BobAdamsEE/bitaxe/3d/SIC431AED-T1-GE3.step

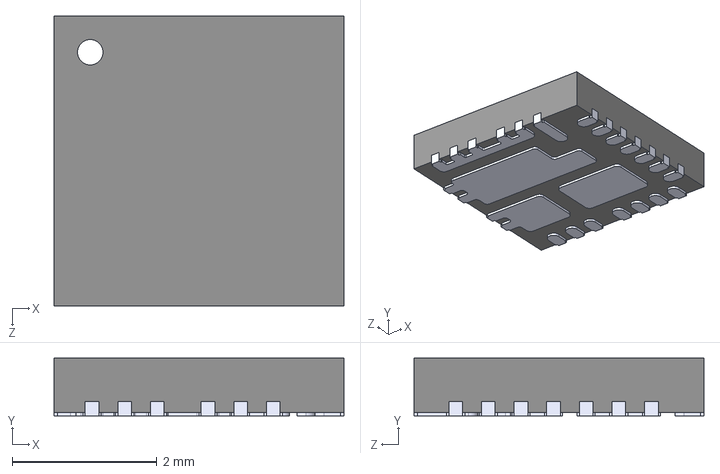
[picture p1: CAD file, 2024-03-04]
3d/SIC431AED-T1-GE3.step
4.00 x 0.8 x 4.00 mm
