BobAdamsEE/bitaxe/3d/SPB1007.stp

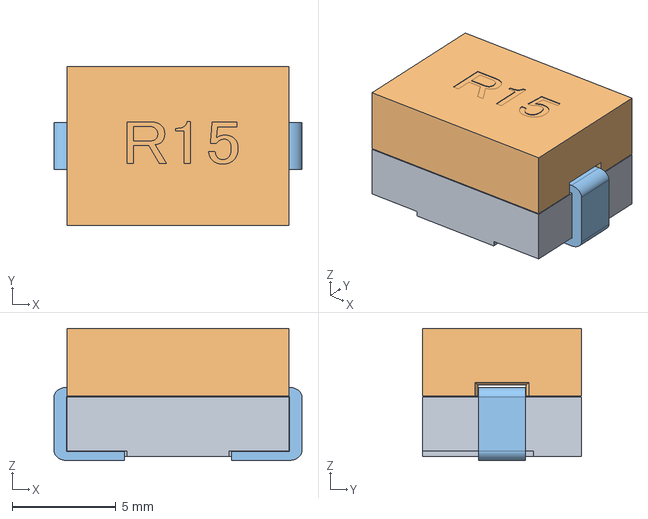
[picture p2: CAD file, 2024-03-04]
3d/SPB1007.stp
12.0 x 7.65 x 6.36 mm
