BobAdamsEE/bitaxe/3d/CAP_WCAP-ASLI_06p3X07p7_WRE.step

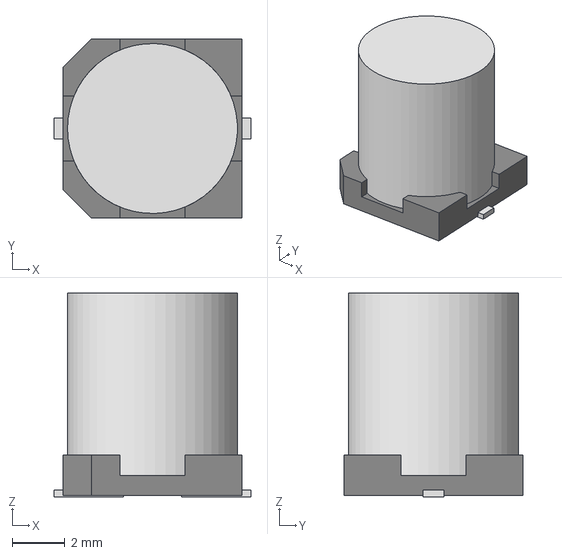
[picture p3: CAD file, 2024-03-04]
3d/CAP_WCAP-ASLI_06p3X07p7_WRE.step
7.49 x 6.81 x 7.75 mm
