BobAdamsEE/bitaxe/3d/TSOT26_DIO.step

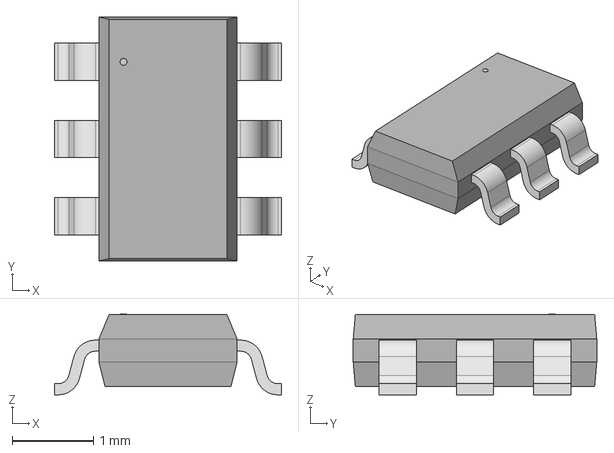
[picture p4: CAD file, 2024-03-04]
3d/TSOT26_DIO.step
2.79 x 3.00 x 0.993 mm
