BobAdamsEE/bitaxe/3d/VLS5045EX-100M.step

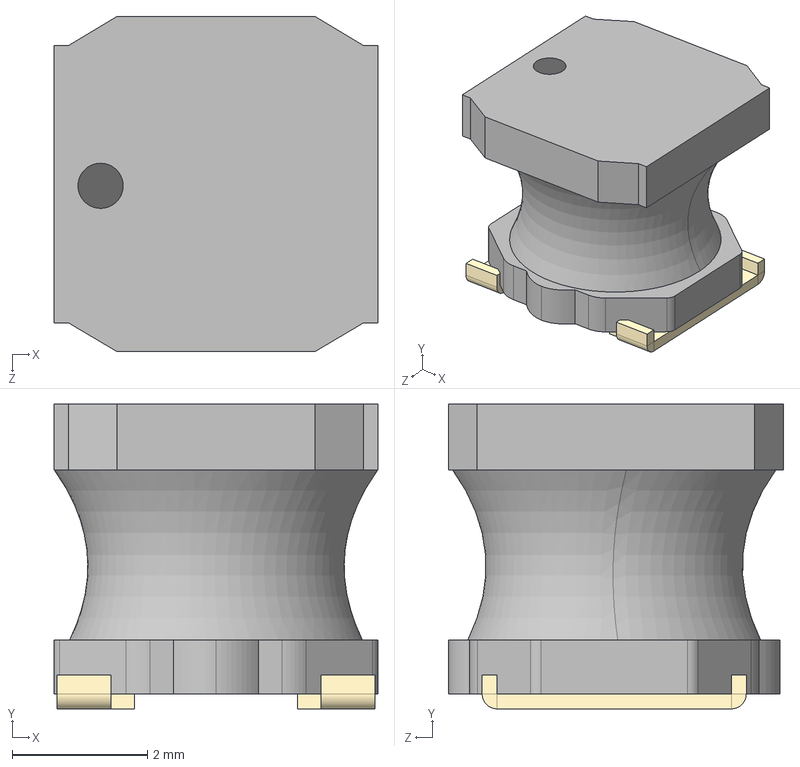
[picture p5: CAD file, 2024-03-04]
3d/VLS5045EX-100M.step
4.78 x 4.50 x 4.95 mm
