BobAdamsEE/bitaxe/3d/SN74AVC4T774PWR.step

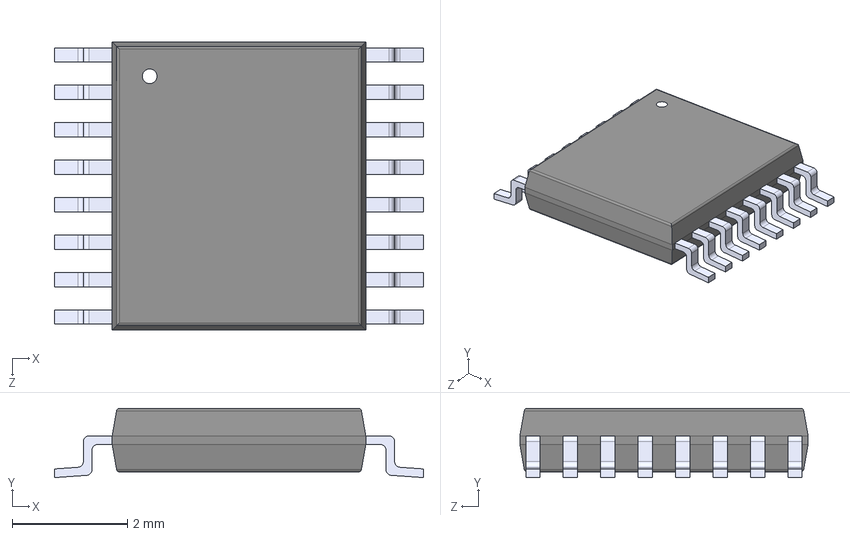
[picture p6: CAD file, 2024-02-27]
3d/SN74AVC4T774PWR.step
6.40 x 1.20 x 5.00 mm
