BobAdamsEE/bitaxe/3d/CUI_DEVICES_PJ-036AH-SMT-TR.step

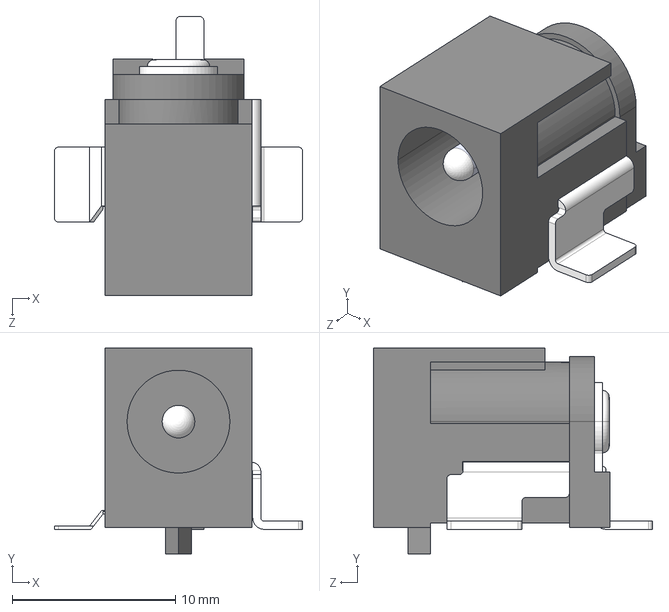
[picture p7: CAD file, 2024-02-14]
3d/CUI_DEVICES_PJ-036AH-SMT-TR.step
15.2 x 12.6 x 17.1 mm
