BobAdamsEE/bitaxe/Bitaxe_205pd_draft_sch.pdf

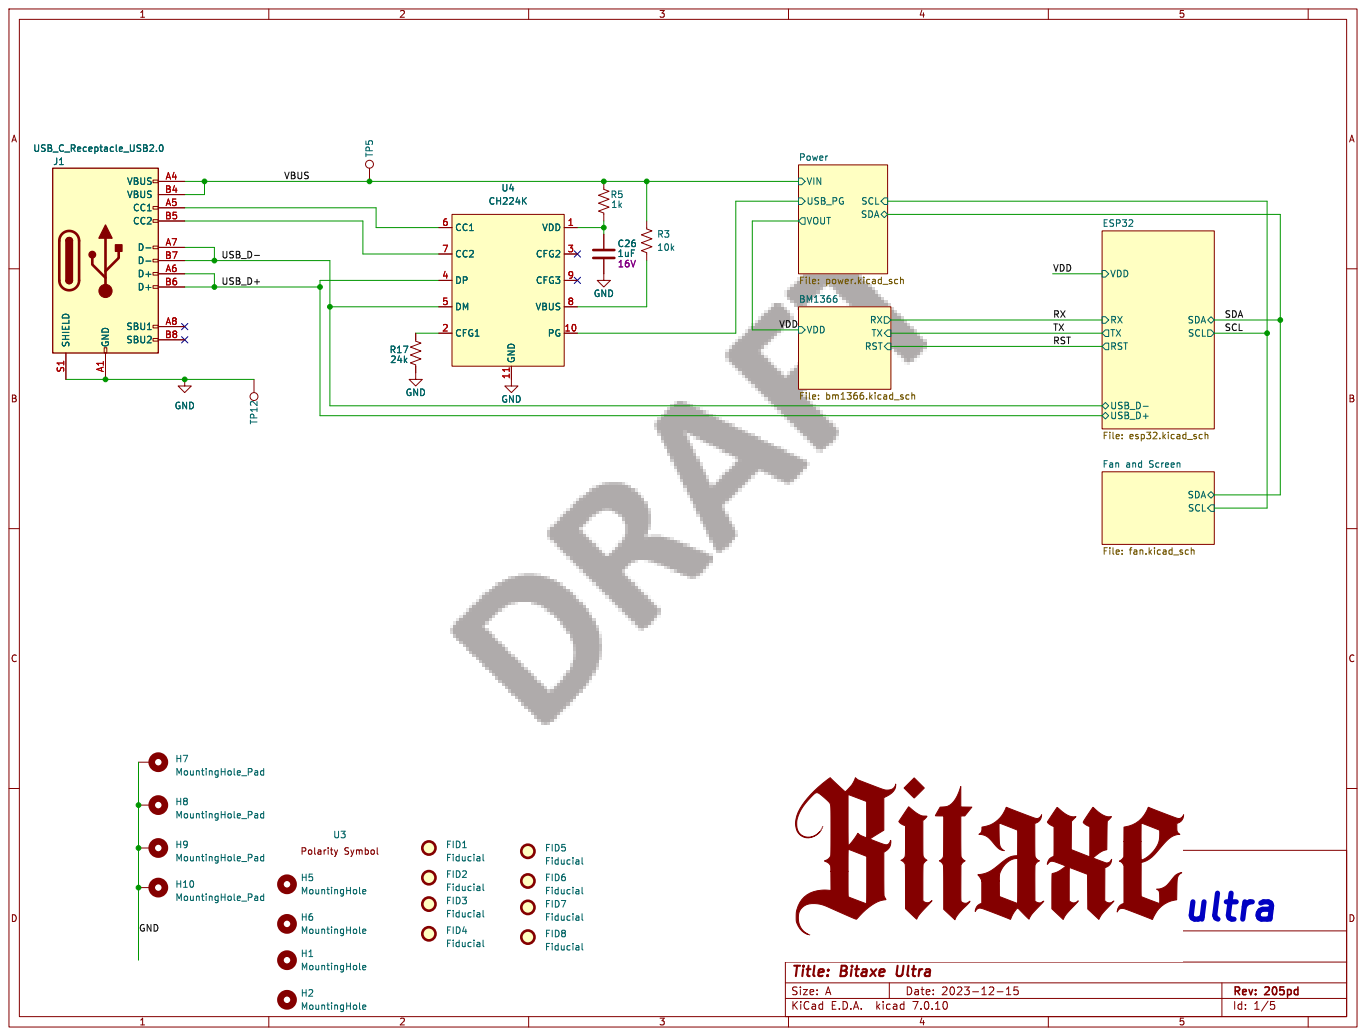
[picture p8: page 1]

Power File: power.kicad_sch TXRX RST VDD

SCL Fan and Screen File: fan.kicad_sch H6 MountingHole

File: bitaxeUltra.kicad_sch Sheet: /
Id: 1/5 Title: Bitaxe Ultra

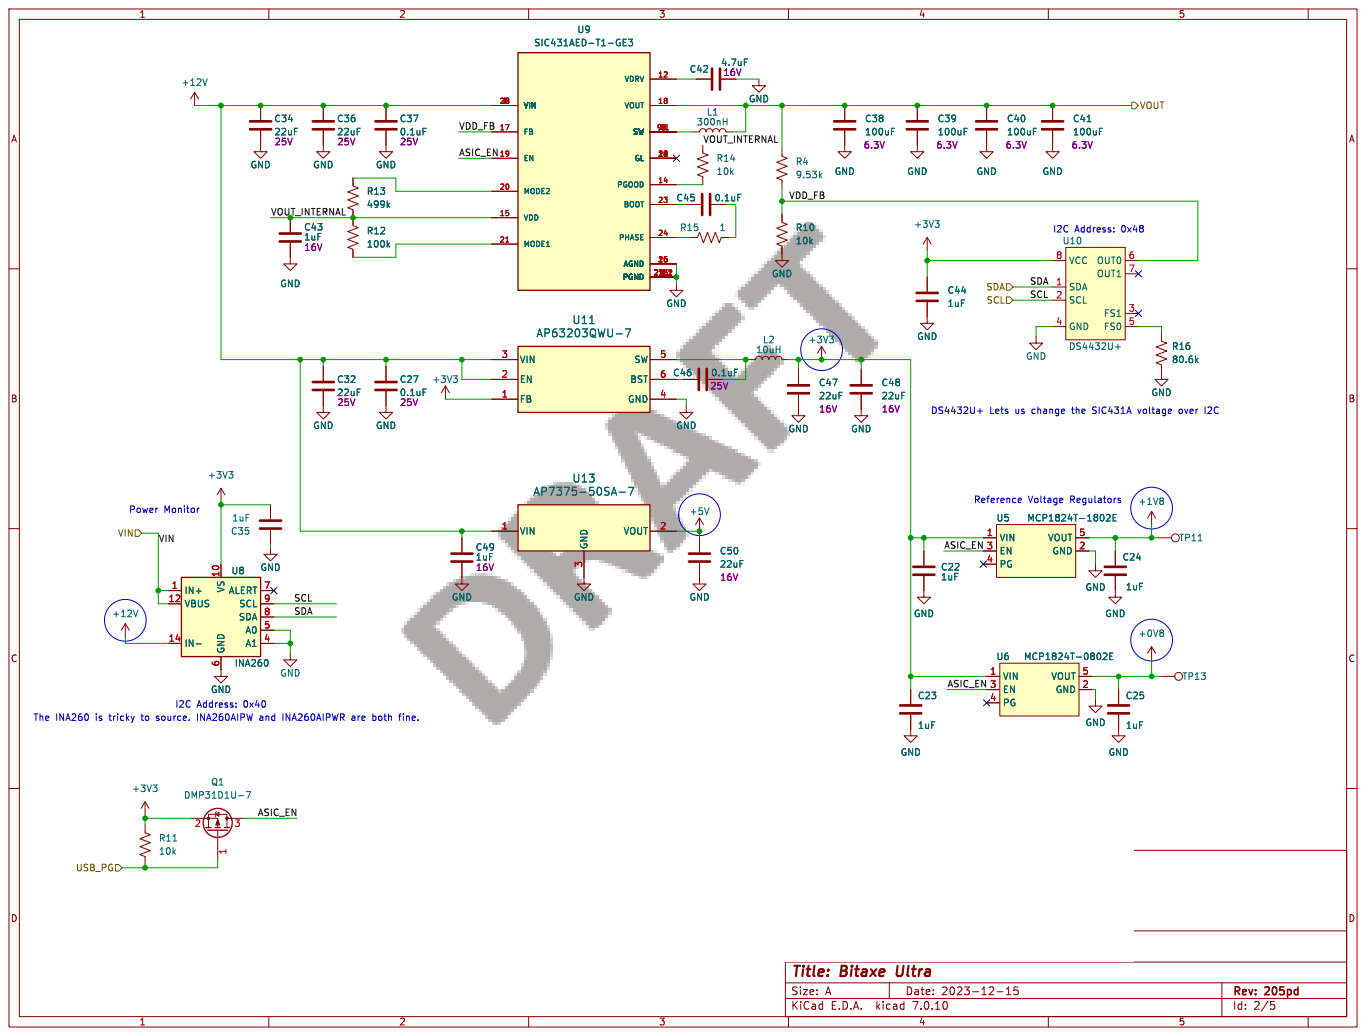
[picture p9: page 2]

Reference Voltage Regulators GND

I2C Address: 0x40 The INA260 is tricky to source. INA260AIPW and INA260AIPWR are both fine. Power Monitor

6 ALERT 7 SDA 8 SCL 9GND GND GND

File: power.kicad_sch Sheet: /Power/
Id: 2/5 Title: Bitaxe Ultra

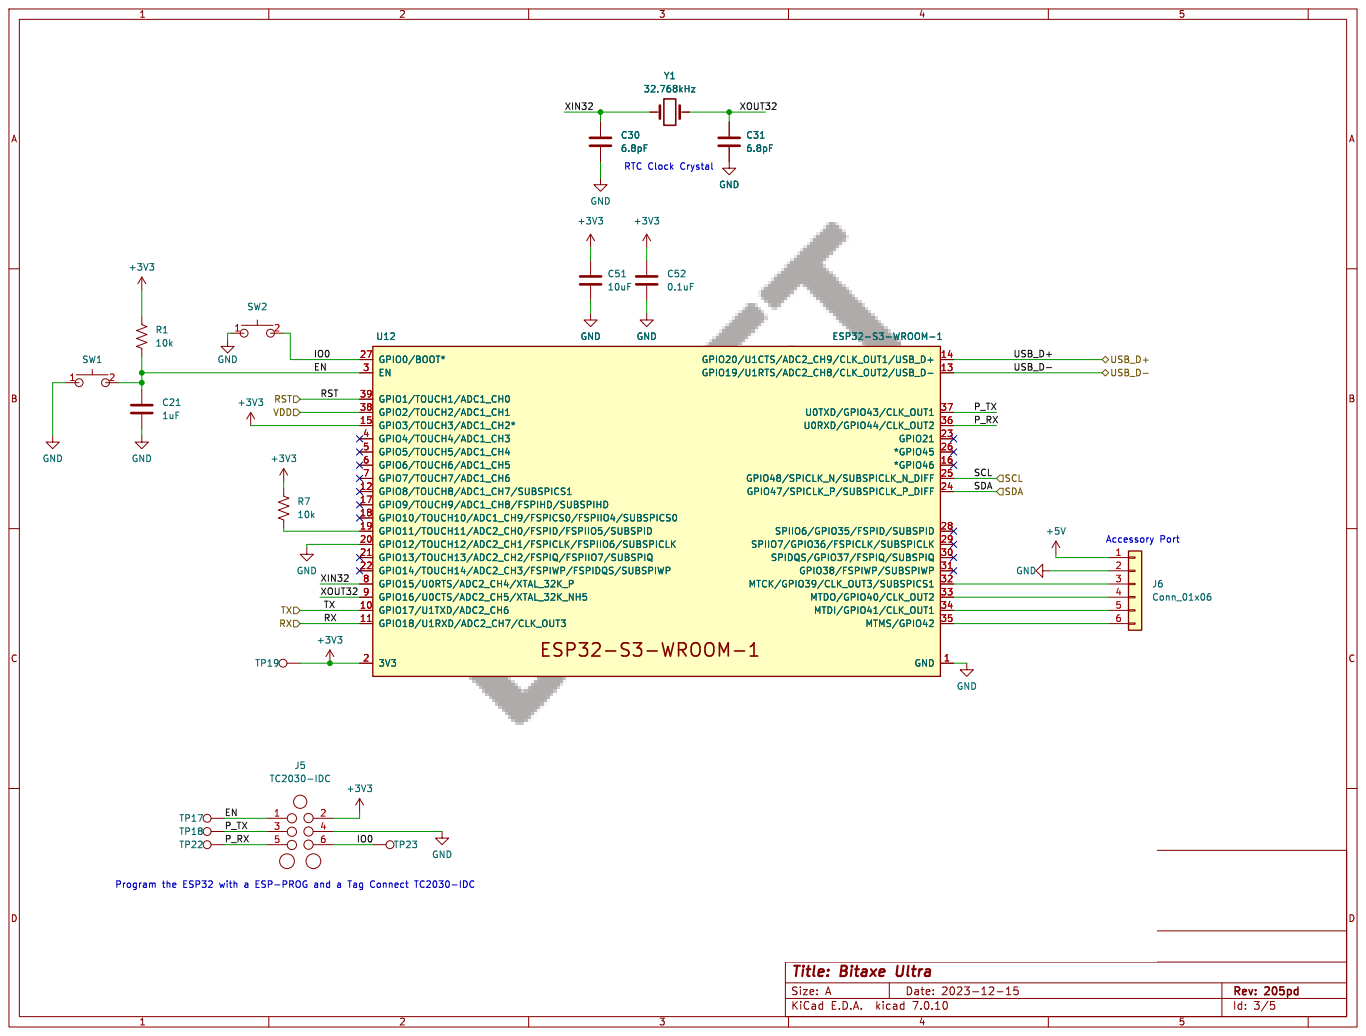
[picture p10: page 3]

Accessory Port Program the ESP32 with a ESP-PROG and a Tag Connect TC2030-IDC

Id: 3/5 Title: Bitaxe Ultra

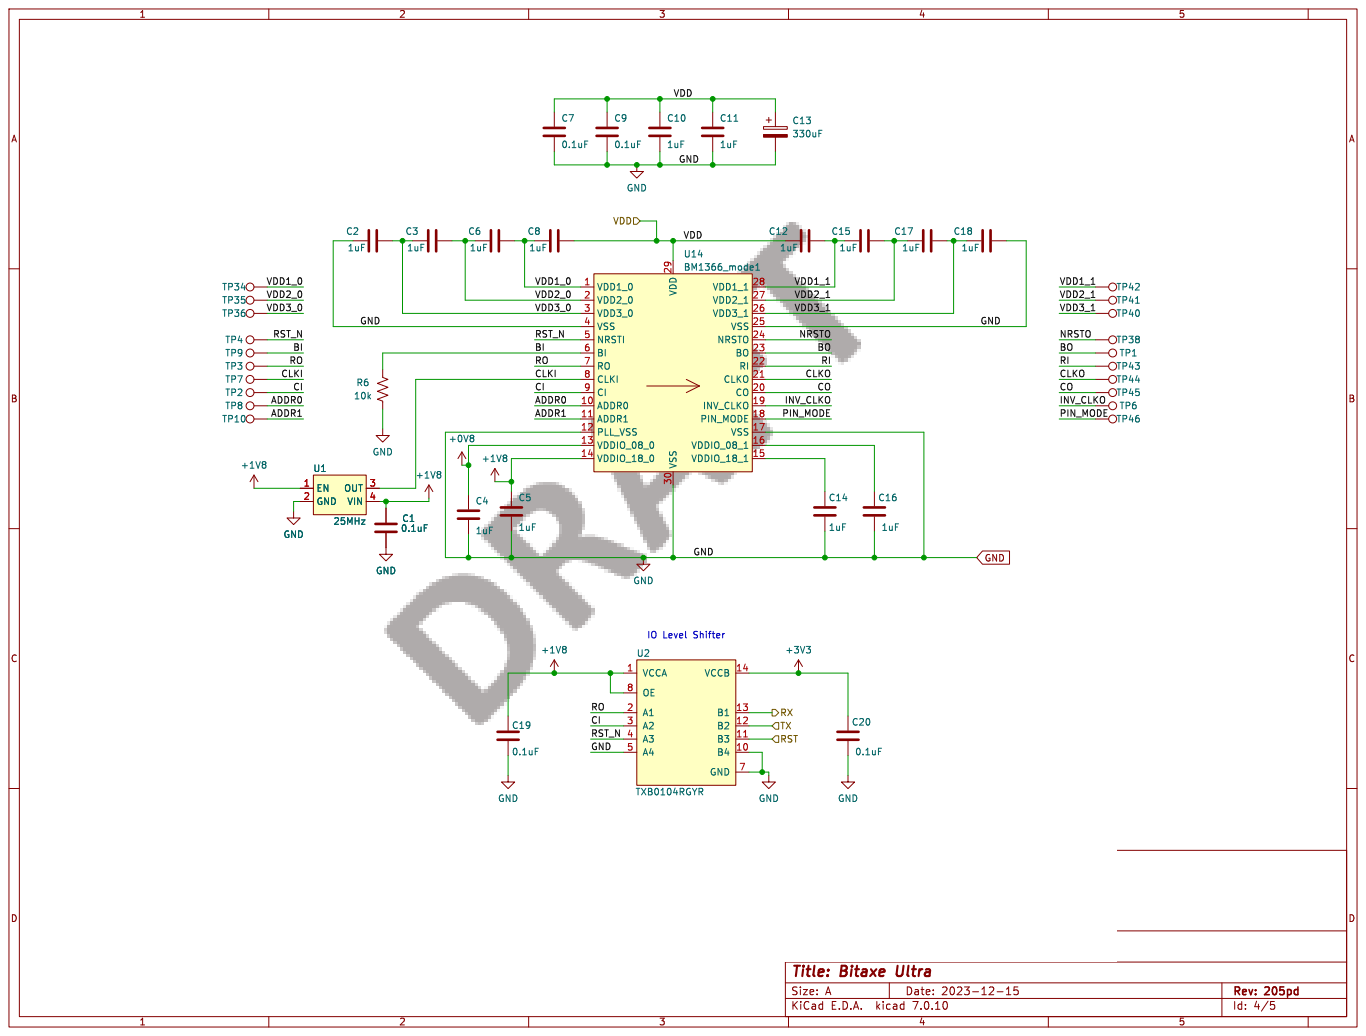
[picture p11: page 4]

IO Level Shifter GND

Id: 4/5 Title: Bitaxe Ultra

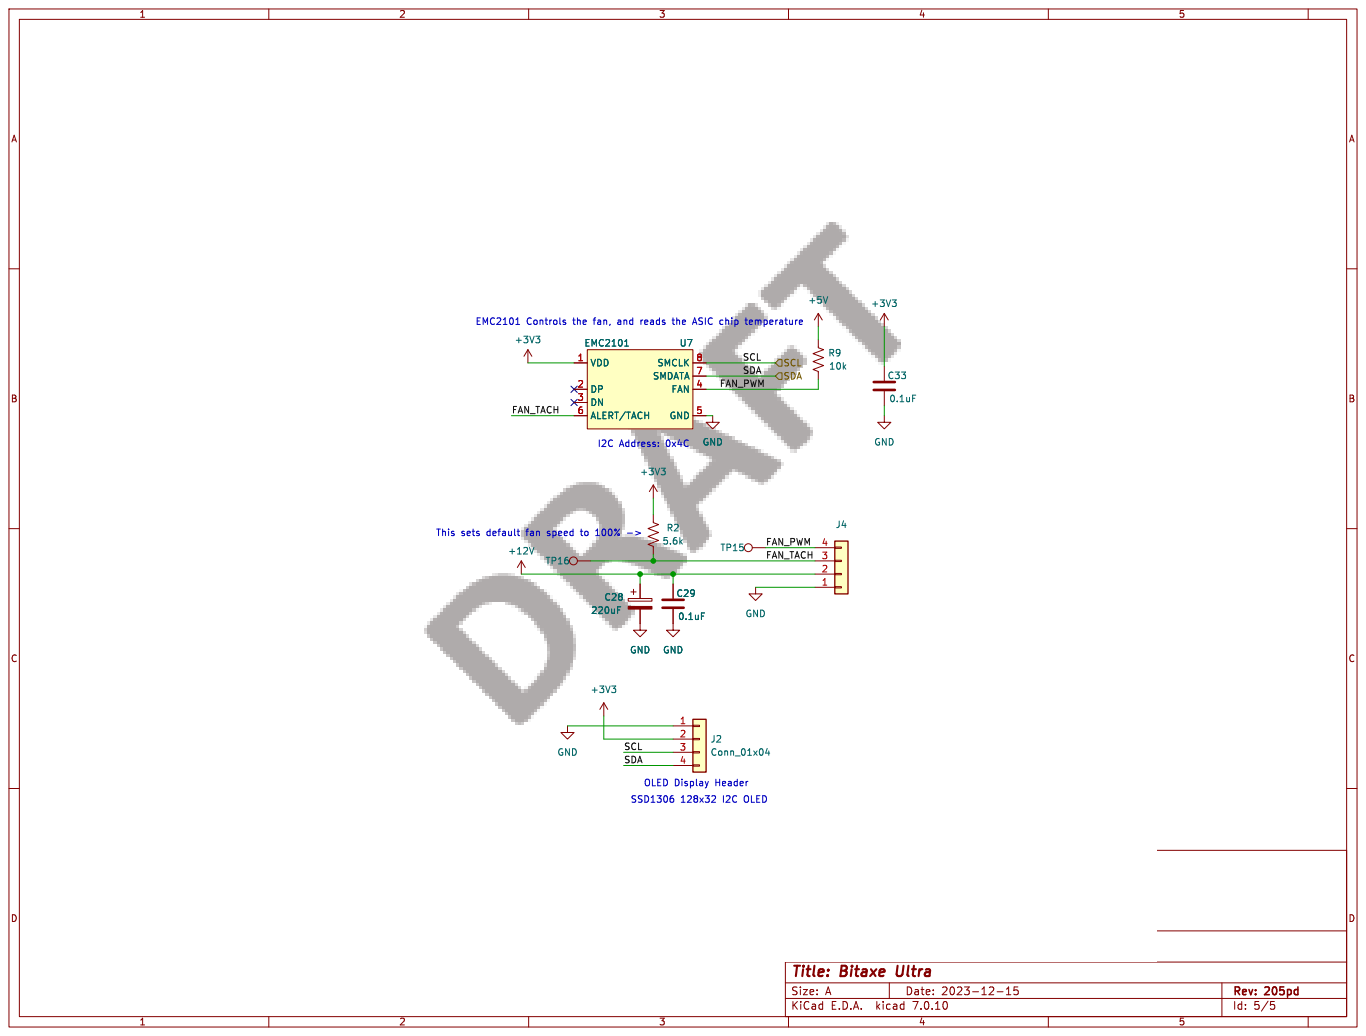
[picture p12: page 5]

SSD1306 128x32 I2C OLED OLED Display Header

Id: 5/5 Title: Bitaxe Ultra
