BobAdamsEE/bitaxe/bitaxeUltra.kicad_pcb

## KiCad design bitaxeUltra.kicad_pcb (2024-03-21)

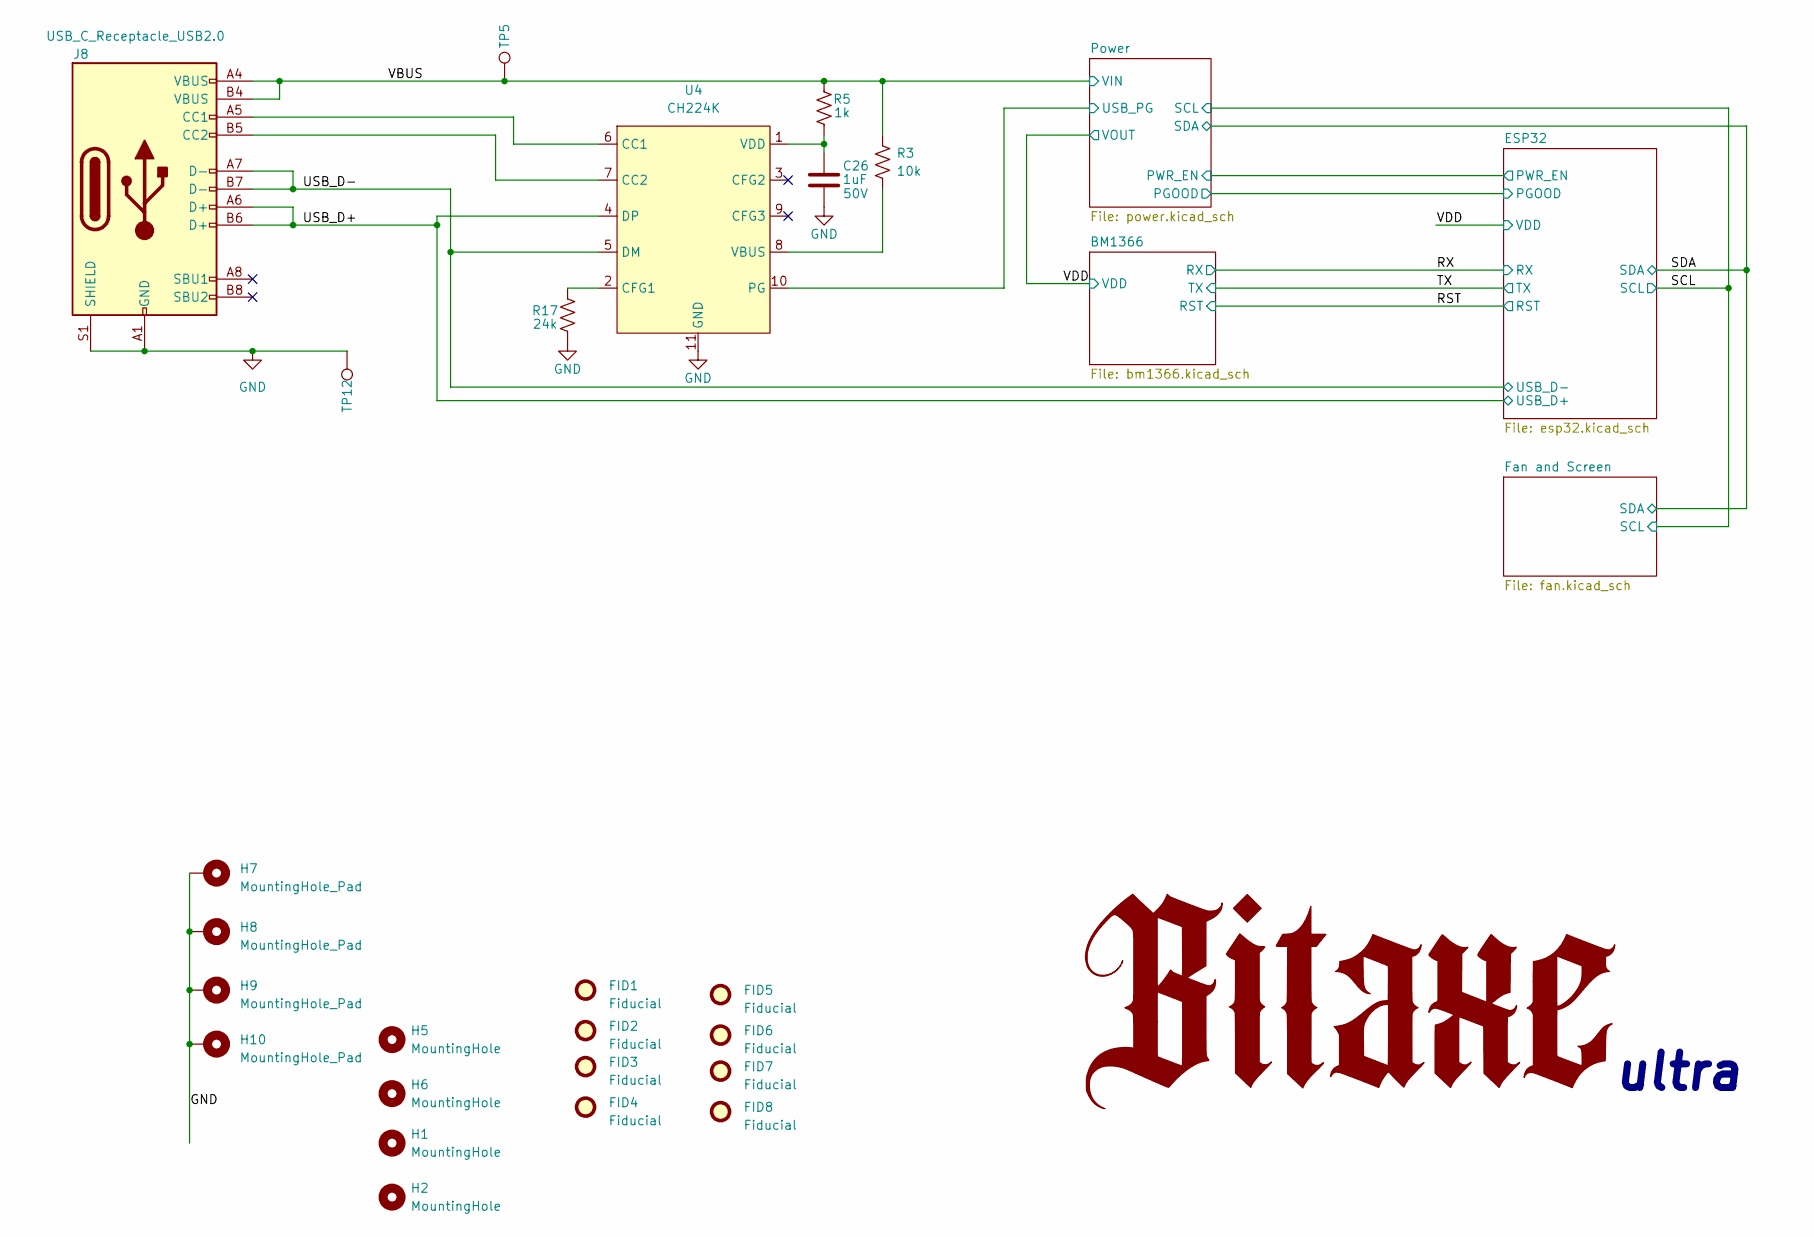
[picture p13: schematic bitaxeUltra.kicad_sch, Bitaxe Ultra]

Parts:
C26: 1uF; C_0603_1608Metric; Voltage 50V; PARTNO CC0603KRX7R9BB105
FID1, FID2, FID3, FID4, FID5, FID6, FID7, FID8: Fiducial; Fiducial_1mm_Mask2mm
H1, H2, H5, H6: MountingHole; MountingHole_3.5mm
H7, H8, H9, H10: MountingHole_Pad; MountingHole_3mm_Pad_Via
J8: USB_C_Receptacle_USB2.0; USB_C_Receptacle_GCT_USB4105-xx-A_16P_TopMnt_Horizontal; PARTNO USB4105-GF-A
R3: 10k; R_0402_1005Metric; PARTNO RC0402JR-0710KL
R5: 1k; R_0402_1005Metric; PARTNO RC0402JR-071KL
R17: 24k; R_0402_1005Metric; PARTNO RC0402JR-0724KL
TP5, TP12: TestPoint; TestPoint_Pad_D3.0mm
U4: CH224K; ESSOP-10; PARTNO CH224K

Connections:
/Power/USB_PG: U4.10 (PG); also elsewhere on the board
/USB_D+: J8.A6 (D+), J8.B6 (D+), U4.4 (DP); also elsewhere on the board
/USB_D-: J8.A7 (D-), J8.B7 (D-), U4.5 (DM); also elsewhere on the board
GND: C26.2, H7.1, H8.1, H9.1, H10.1, J8.A1 (GND), J8.B1 (GND), J8.S1 (SHIELD), R17.1, TP12.1, U4.11 (GND); also elsewhere on the board
IN+: J8.A4 (VBUS), J8.B4 (VBUS), R3.1, R5.2, TP5.1; also elsewhere on the board
unnamed: J8.A5 (CC1), U4.6 (CC1)
unnamed: J8.B5 (CC2), U4.7 (CC2)
unnamed: R17.2, U4.2 (CFG1)
unnamed: R3.2, U4.8 (VBUS)
unnamed: C26.1, R5.1, U4.1 (VDD)

Notes on the sheet:
ultra

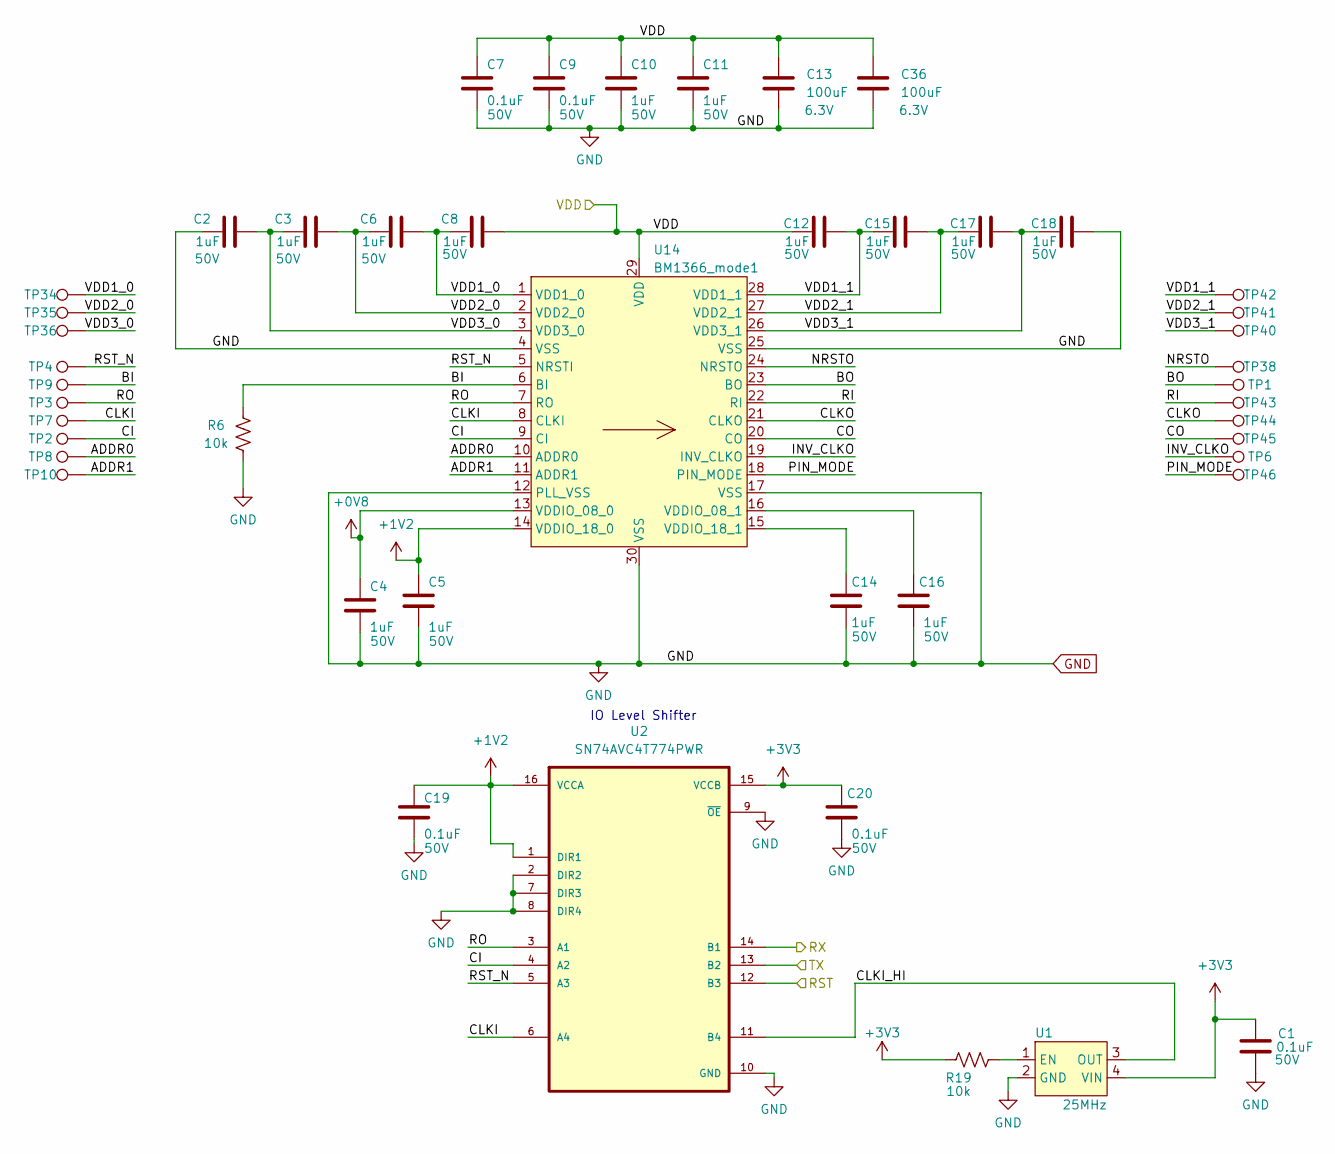
[picture p14: schematic bm1366.kicad_sch, Bitaxe Ultra]

Parts:
C1, C7, C9, C19, C20: 0.1uF; C_0402_1005Metric; Voltage 50V; PARTNO GRM155R71H104KE14J
C2, C3, C4, C5, C6, C8, C10, C11, C12, C14, C15, C16, C17, C18: 1uF; C_0603_1608Metric; Voltage 50V; PARTNO CC0603KRX7R9BB105
C13, C36: 100uF; C_1206_3216Metric; Voltage 6.3V; PARTNO GRM31CD80J107MEA8K
R6, R19: 10k; R_0402_1005Metric; PARTNO RC0402JR-0710KL
TP1, TP2, TP3, TP4, TP6, TP7, TP8, TP9, TP10, TP34, TP35, TP36, TP38, TP40, TP41, TP42, TP43, TP44, TP45, TP46: TestPoint; TestPoint_Pad_D1.5mm
U1: 25MHz; O 25,0-JO32-B-1V3-1-T1-LF; PARTNO O 25,0-JO32-B-1V3-1-T1-LF
U2: SN74AVC4T774PWR; SOP65P640X120-16N; PARTNO SN74AVC4T774PWR
U14: BM1366_mode1; BM1366

Connections:
+0V8: C4.1, U14.13 (VDDIO_08_0); also elsewhere on the board
+1V2: C5.1, C19.1, U2.1 (DIR1), U2.16 (VCCA), U14.14 (VDDIO_18_0); also elsewhere on the board
+3V3: C1.2, C20.1, R19.2, U1.4 (VIN), U2.15 (VCCB); also elsewhere on the board
/BM1366/ADDR0: TP8.1, U14.10 (ADDR0)
/BM1366/ADDR1: TP10.1, U14.11 (ADDR1)
/BM1366/BI: R6.2, TP9.1, U14.6 (BI)
/BM1366/BO: TP1.1, U14.23 (BO)
/BM1366/CI: TP2.1, U2.4 (A2), U14.9 (CI)
/BM1366/CLKI: TP7.1, U2.6 (A4), U14.8 (CLKI)
/BM1366/CLKI_HI: U1.3 (OUT), U2.11 (B4)
/BM1366/CLKO: TP44.1, U14.21 (CLKO)
/BM1366/CO: TP45.1, U14.20 (CO)
/BM1366/INV_CLKO: TP6.1, U14.19 (INV_CLKO)
/BM1366/NRSTO: TP38.1, U14.24 (NRSTO)
/BM1366/PIN_MODE: TP46.1, U14.18 (PIN_MODE)
/BM1366/RI: TP43.1, U14.22 (RI)
/BM1366/RO: TP3.1, U2.3 (A1), U14.7 (RO)
/BM1366/RST_N: TP4.1, U2.5 (A3), U14.5 (NRSTI)
/BM1366/VDD1_0: C6.2, C8.1, TP34.1, U14.1 (VDD1_0)
/BM1366/VDD1_1: C12.2, C15.1, TP42.1, U14.28 (VDD1_1)
/BM1366/VDD2_0: C3.2, C6.1, TP35.1, U14.2 (VDD2_0)
/BM1366/VDD2_1: C15.2, C17.1, TP41.1, U14.27 (VDD2_1)
/BM1366/VDD3_0: C2.2, C3.1, TP36.1, U14.3 (VDD3_0)
/BM1366/VDD3_1: C17.2, C18.1, TP40.1, U14.26 (VDD3_1)
/RST: U2.12 (B3); also elsewhere on the board
/RX: U2.14 (B1); also elsewhere on the board
/TX: U2.13 (B2); also elsewhere on the board
/VDD: C7.1, C8.2, C9.1, C10.1, C11.1, C12.1, C13.1, C36.1, U14.29 (VDD); also elsewhere on the board
GND: C1.1, C2.1, C4.2, C5.2, C7.2, C9.2, C10.2, C11.2, C13.2, C14.2, C16.2, C18.2, C19.2, C20.2, C36.2, R6.1, U1.2 (GND), U2.2 (DIR2), U2.7 (DIR3), U2.8 (DIR4), U2.9 (~OE), U2.10 (GND), U14.4 (VSS), U14.12 (PLL_VSS), U14.17 (VSS), U14.25 (VSS), U14.30 (VSS); also elsewhere on the board
unnamed: R19.1, U1.1 (EN)
unnamed: C16.1, U14.16 (VDDIO_08_1)
unnamed: C14.1, U14.15 (VDDIO_18_1)

Notes on the sheet:
IO Level Shifter

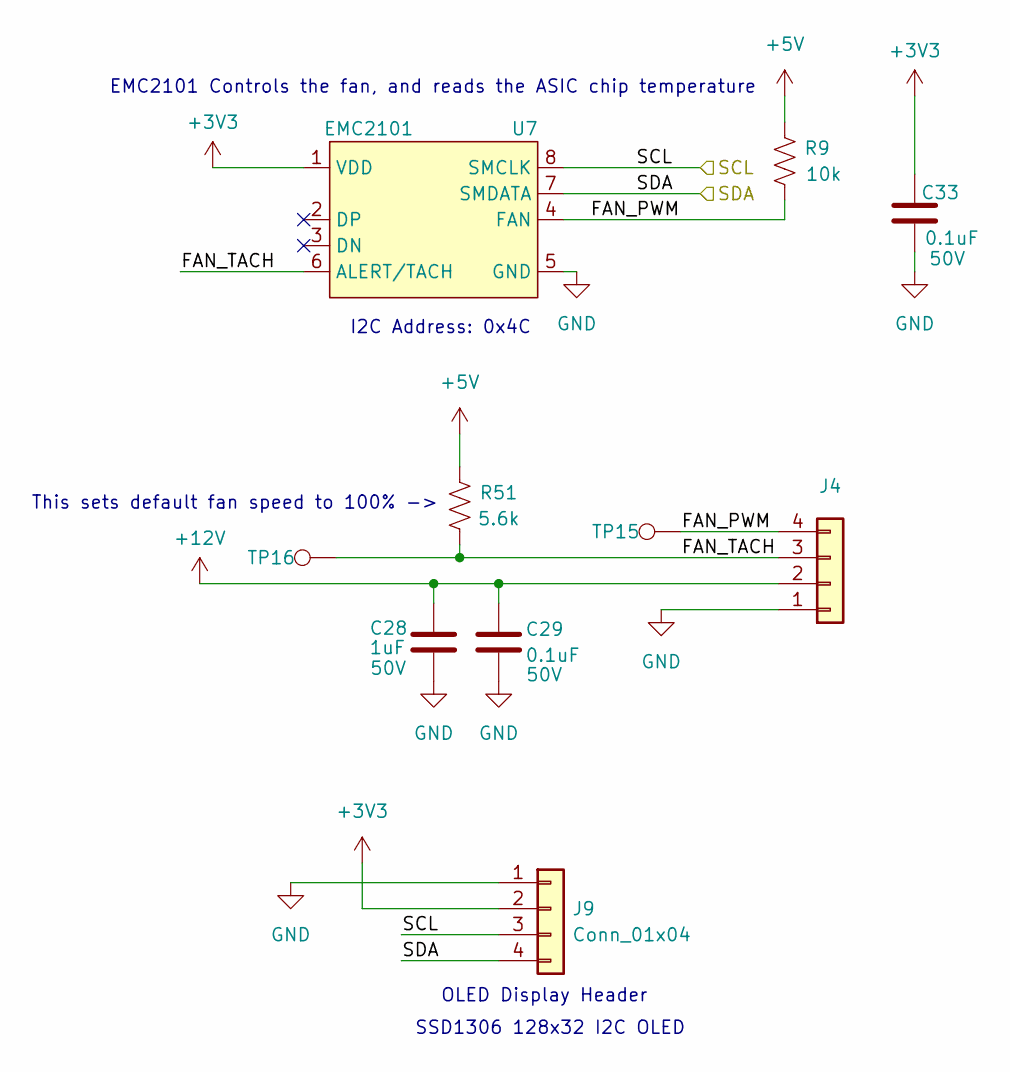
[picture p15: schematic fan.kicad_sch, Bitaxe Ultra]

Parts:
C28: 1uF; C_0603_1608Metric; Voltage 50V; PARTNO CC0603KRX7R9BB105
C29, C33: 0.1uF; C_0402_1005Metric; Voltage 50V; PARTNO GRM155R71H104KE14J
J4: Conn_01x04; 470531000; PARTNO 0470531000
J9: Conn_01x04; PinHeader_1x04_P2.54mm_Vertical_shifted; PARTNO NPTC041KFXC-RC
R9: 10k; R_0402_1005Metric; PARTNO RC0402JR-0710KL
R51: 5.6k; R_0402_1005Metric; PARTNO RC0402FR-135K6L
TP15, TP16: TestPoint; TestPoint_Pad_D1.5mm
U7: EMC2101; TSSOP-8_3x3mm_P0.65mm; PARTNO EMC2101-R-ACZL-TR

Connections:
+3V3: C33.1, J9.2, U7.1 (VDD); also elsewhere on the board
+5V: R9.2; also elsewhere on the board
+12V: C28.1, C29.1, J4.2; also elsewhere on the board
/Fan and Screen/FAN_PWM: J4.4, R9.1, TP15.1, U7.4 (FAN)
/Fan and Screen/FAN_TACH: J4.3, TP16.1, U7.6 (ALERT/TACH); also elsewhere on the board
/SCL: J9.3, U7.8 (SMCLK); also elsewhere on the board
/SDA: J9.4, U7.7 (SMDATA); also elsewhere on the board
GND: C28.2, C29.2, C33.2, J4.1, J9.1, U7.5 (GND); also elsewhere on the board

Notes on the sheet:
SSD1306 128x32 I2C OLED
EMC2101 Controls the fan, and reads the ASIC chip temperature
This sets default fan speed to 100% ->
OLED Display Header
I2C Address: 0x4C

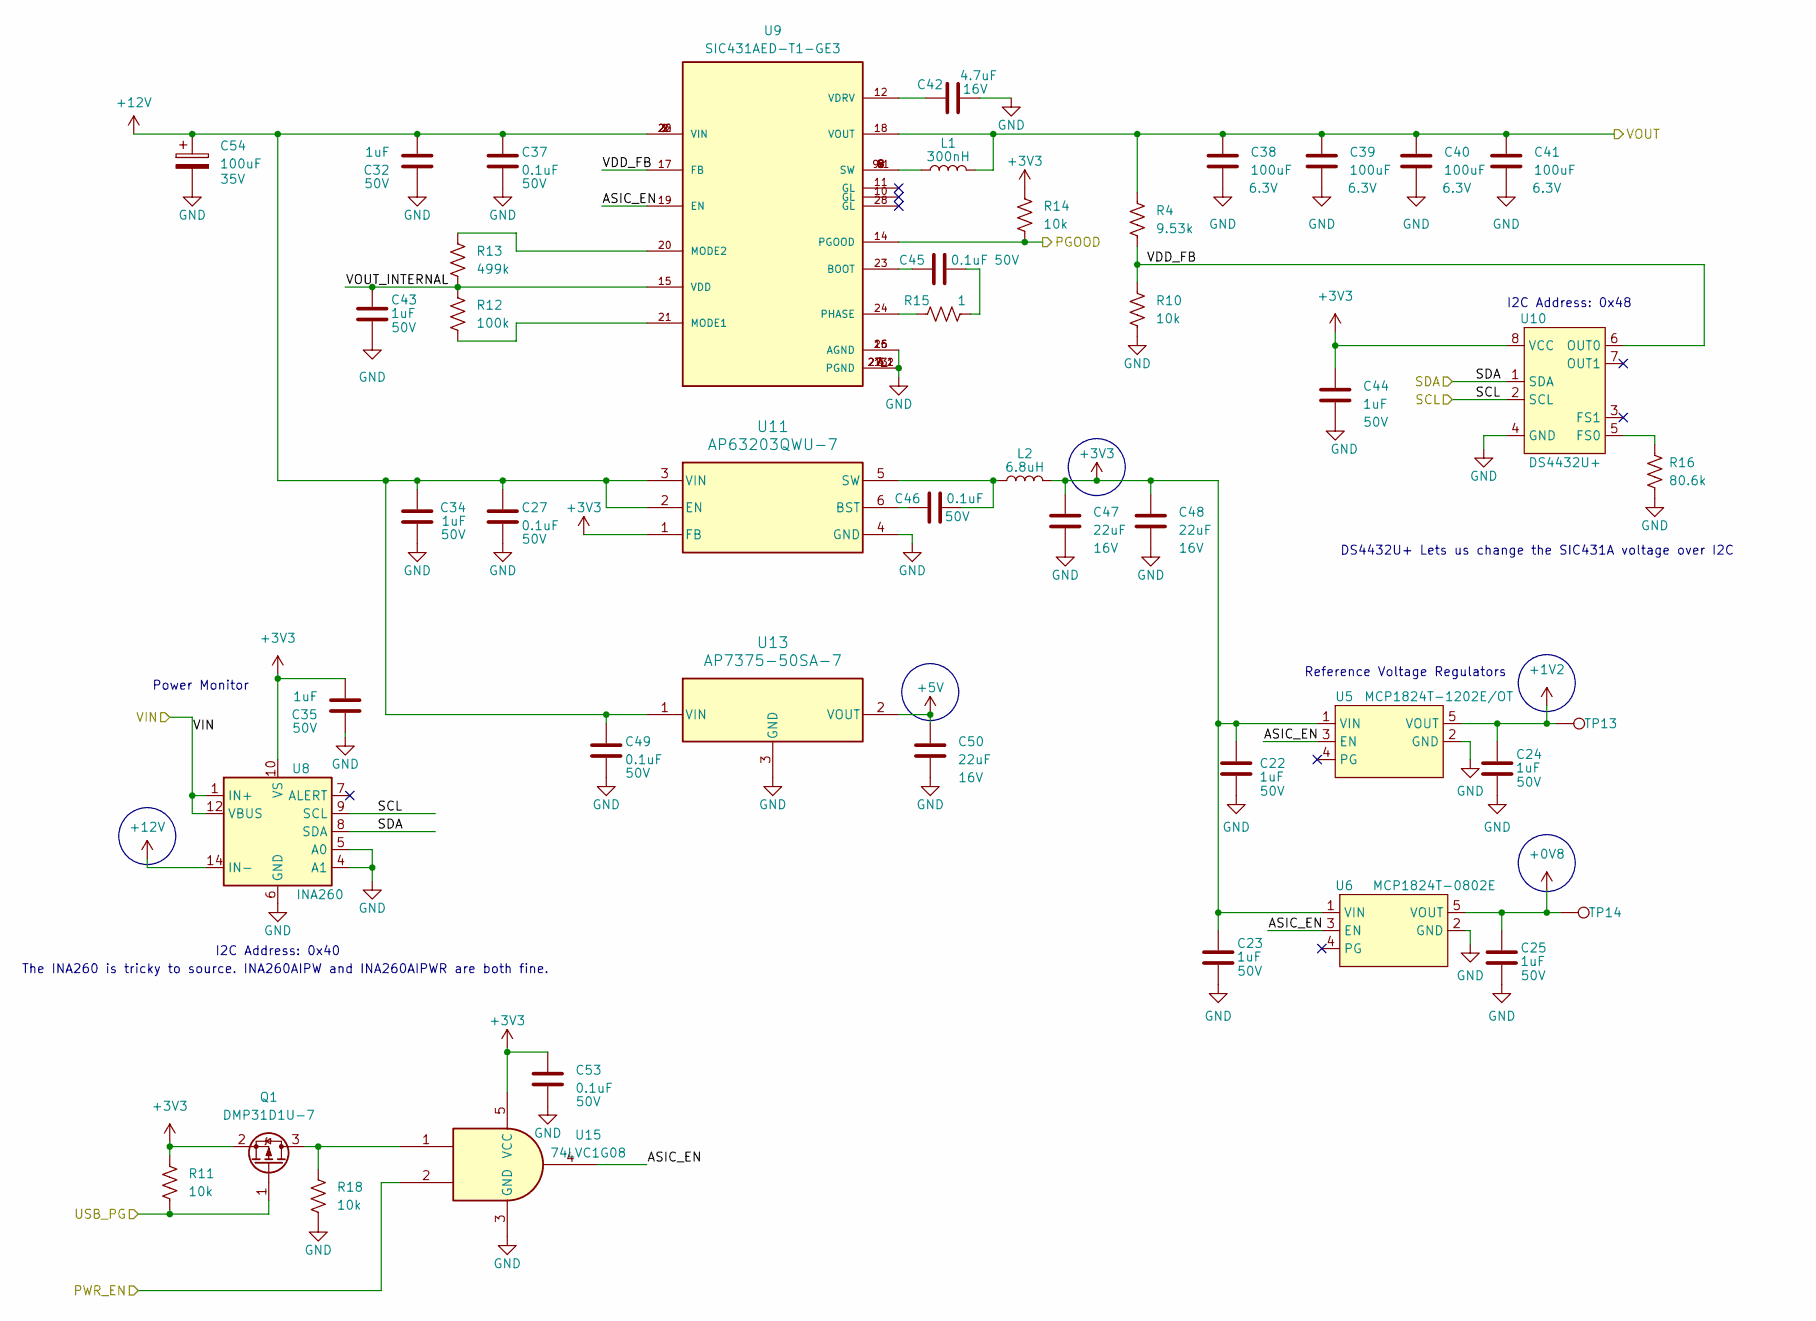
[picture p16: schematic power.kicad_sch, Bitaxe Ultra]

Parts:
C22, C23, C24, C25, C32, C34, C35, C43, C44: 1uF; C_0603_1608Metric; Voltage 50V; PARTNO CC0603KRX7R9BB105
C27, C37, C45, C46, C49, C53: 0.1uF; C_0402_1005Metric; Voltage 50V; PARTNO GRM155R71H104KE14J
C38, C39, C40, C41: 100uF; C_1206_3216Metric; Voltage 6.3V; PARTNO GRM31CD80J107MEA8K
C42: 4.7uF; C_0805_2012Metric; Voltage 16V; PARTNO GRM21BR71C475KE51K
C47, C48, C50: 22uF; C_0805_2012Metric; Voltage 16V; PARTNO GRM21BC81C226ME44L
C54: 100uF; CAP_WCAP-ASLI_06p3X07p7_WRE; Voltage 35V; PARTNO 865080545012
L1: 300nH; INDUCTOR_SPB1007-R30M; PARTNO SPB1007-R30M
L2: 6.8uH; IND_VLS5045EX-100M; PARTNO VLS5045EX-6R8M
Q1: DMP31D1U-7; DIODESINC_SOT-23; PARTNO DMP31D1U-7
R4: 9.53k; R_0402_1005Metric; PARTNO RC0402FR-079K53L
R10, R11, R14, R18: 10k; R_0402_1005Metric; PARTNO RC0402JR-0710KL
R12: 100k; R_0402_1005Metric; PARTNO RC0402FR-07100KL
R13: 499k; R_0402_1005Metric; PARTNO RC0402FR-07499KL
R15: 1; R_0402_1005Metric; PARTNO RC0402JR-071RL
R16: 80.6k; R_0402_1005Metric; PARTNO RC0402FR-0780K6L
TP13, TP14: TestPoint; TestPoint_Pad_D1.5mm
U5: MCP1824T-1202E/OT; SOT-23-5; PARTNO MCP1824T-1202E/OT
U6: MCP1824T-0802E; SOT-23-5; PARTNO MCP1824T-0802E/OT
U8: INA260; TSSOP-16_4.4x5mm_P0.65mm; PARTNO INA260AIPW
U9: SIC431AED-T1-GE3; REGULATOR_SIC431AED-T1-GE3; PARTNO SIC431AED-T1-GE3
U10: DS4432U+; TSSOP-8_3x3mm_P0.65mm; PARTNO DS4432U+
U11: AP63203QWU-7; TSOT26_DIO; PARTNO AP63203QWU-7
U13: AP7375-50SA-7; DIODESINC_SOT-23; PARTNO AP7375-50SA-7
U15: 74LVC1G08; SOT-353_SC-70-5; PARTNO 74LVC1G08GW,125

Connections:
+0V8: C25.1, TP14.1, U6.5 (VOUT); also elsewhere on the board
+1V2: C24.1, TP13.1, U5.5 (VOUT); also elsewhere on the board
+3V3: C22.1, C23.1, C35.2, C44.1, C47.1, C48.1, C53.1, L2.2, Q1.2 (S), R11.1, R14.1, U5.1 (VIN), U6.1 (VIN), U8.10 (VS), U10.8 (VCC), U11.1 (FB), U15.5 (VCC); also elsewhere on the board
+5V: C50.1, U13.2 (VOUT); also elsewhere on the board
+12V: C27.1, C32.2, C34.2, C37.1, C49.1, C54.1, U8.14 (IN-), U8.15 (IN-), U8.16 (IN-), U9.1 (VIN), U9.2 (VIN), U9.22 (VIN), U9.26 (VIN), U11.2 (EN), U11.3 (VIN), U13.1 (VIN); also elsewhere on the board
/ESP32/PGOOD: R14.2, U9.14 (PGOOD); also elsewhere on the board
/ESP32/PWR_EN: U15.2; also elsewhere on the board
/Power/ASIC_EN: U5.3 (EN), U6.3 (EN), U9.19 (EN), U15.4
/Power/USB_PG: Q1.1 (G), R11.2; also elsewhere on the board
/Power/VDD_FB: R4.2, R10.1, U9.17 (FB), U10.6 (OUT0)
/Power/VOUT_INTERNAL: C43.1, R12.1, R13.2, U9.15 (VDD)
/SCL: U8.9 (SCL), U10.2 (SCL); also elsewhere on the board
/SDA: U8.8 (SDA), U10.1 (SDA); also elsewhere on the board
/VDD: C38.1, C39.1, C40.1, C41.1, L1.2, R4.1, U9.18 (VOUT); also elsewhere on the board
GND: C22.2, C23.2, C24.2, C25.2, C27.2, C32.1, C34.1, C35.1, C37.2, C38.2, C39.2, C40.2, C41.2, C42.2, C43.2, C44.2, C47.2, C48.2, C49.2, C50.2, C53.2, C54.2, R10.2, R16.2, R18.2, U5.2 (GND), U6.2 (GND), U8.4 (A1), U8.5 (A0), U8.6 (GND), U8.11 (GND), U9.3 (PGND), U9.4 (PGND), U9.13 (PGND), U9.16 (AGND), U9.25 (AGND), U9.27_1 (PGND), U9.27_2 (PGND), U10.4 (GND), U11.4 (GND), U13.3 (GND), U15.3 (GND); also elsewhere on the board
IN+: U8.1 (IN+), U8.2 (IN+), U8.3 (IN+), U8.12 (VBUS); also elsewhere on the board
unnamed: C45.2, R15.2
unnamed: L1.1, U9.5 (SW), U9.6 (SW), U9.7 (SW), U9.8 (SW), U9.9 (SW), U9.9.1 (SW)
unnamed: Q1.3 (D), R18.1, U15.1
unnamed: C45.1, U9.23 (BOOT)
unnamed: R12.2, U9.21 (MODE1)
unnamed: R13.1, U9.20 (MODE2)
unnamed: R15.1, U9.24 (PHASE)
unnamed: C42.1, U9.12 (VDRV)
unnamed: R16.1, U10.5 (FS0)
unnamed: C46.1, U11.6 (BST)
unnamed: C46.2, L2.1, U11.5 (SW)

Notes on the sheet:
DS4432U+ Lets us change the SIC431A voltage over I2C
I2C Address: 0x48
The INA260 is tricky to source. INA260AIPW and INA260AIPWR are both fine.
Power Monitor
Reference Voltage Regulators
I2C Address: 0x40

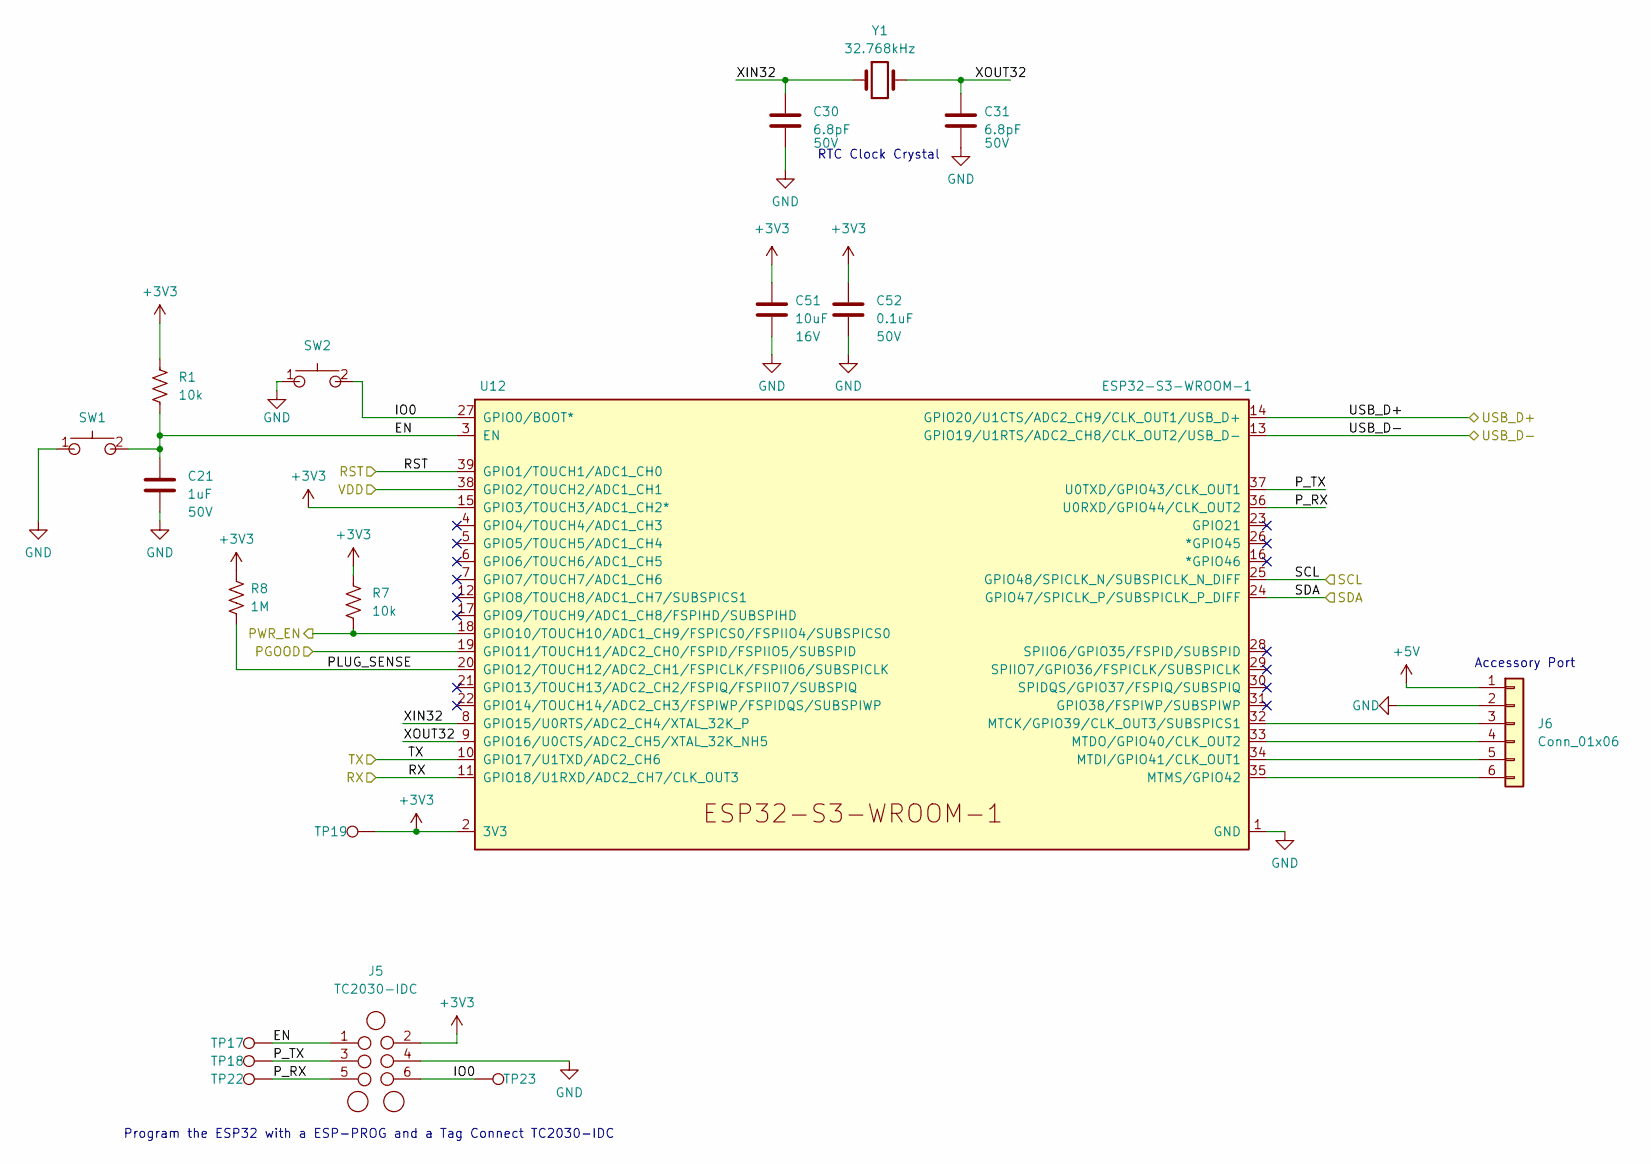
[picture p17: schematic esp32.kicad_sch, Bitaxe Ultra]

Parts:
C21: 1uF; C_0603_1608Metric; Voltage 50V; PARTNO CC0603KRX7R9BB105
C30, C31: 6.8pF; C_0402_1005Metric; Voltage 50V; PARTNO C0402C689C5GAC7867
C51: 10uF; C_0805_2012Metric; Voltage 16V; PARTNO CL21A106KOQNNNE
C52: 0.1uF; C_0402_1005Metric; Voltage 50V; PARTNO GRM155R71H104KE14J
J5: TC2030-IDC; Tag-Connect_TC2030-IDC-NL_2x03_P1.27mm_Vertical
J6: Conn_01x06; PinHeader_1x06_P2.54mm_Vertical
R1, R7: 10k; R_0402_1005Metric; PARTNO RC0402JR-0710KL
R8: 1M; R_0402_1005Metric; PARTNO RC0402FR-071ML
SW1, SW2: GT-TC029B-H025-L1N; SW_CS1213AGF260_CRS; PARTNO CS1213AGF260
TP17, TP18, TP19, TP22, TP23: TestPoint; TestPoint_Pad_D1.5mm
U12: ESP32-S3-WROOM-1; PARTNO ESP32-S3-WROOM-1-N16R8
Y1: 32.768kHz; SC32S-7PF20PPM; PARTNO SC32S-7PF20PPM

Connections:
+3V3: C51.1, C52.1, J5.2, R1.1, R7.1, R8.1, TP19.1, U12.2 (3V3), U12.15 (GPIO3/TOUCH3/ADC1_CH2*); also elsewhere on the board
+5V: J6.1; also elsewhere on the board
/ESP32/EN: C21.1, J5.1, R1.2, SW1.2, TP17.1, U12.3 (EN)
/ESP32/IO0: J5.6, SW2.2, TP23.1, U12.27 (GPIO0/BOOT*)
/ESP32/PGOOD: U12.19 (GPIO11/TOUCH11/ADC2_CH0/FSPID/FSPIIO5/S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); also elsewhere on the board
/ESP32/PLUG_SENSE: R8.2, U12.20 (GPIO12/TOUCH12/ADC2_CH1/FSPICLK/FSPIIO6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)
/ESP32/PWR_EN: R7.2, U12.18 (GPIO10/TOUCH10/ADC1_CH9/FSPICS0/FSPIIO4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); also elsewhere on the board
/ESP32/P_RX: J5.5, TP22.1, U12.36 (U0RXD/GPIO44/CLK_OUT2)
/ESP32/P_TX: J5.3, TP18.1, U12.37 (U0TXD/GPIO43/CLK_OUT1)
/ESP32/XIN32: C30.1, U12.8 (GPIO15/U0RTS/ADC2_CH4/XTAL_32K_P), Y1.1
/ESP32/XOUT32: C31.1, U12.9 (GPIO16/U0CTS/ADC2_CH5/XTAL_32K_NH5), Y1.2
/RST: U12.39 (GPIO1/TOUCH1/ADC1_CH0); also elsewhere on the board
/RX: U12.11 (GPIO18/U1RXD/ADC2_CH7/CLK_OUT3); also elsewhere on the board
/SCL: U12.25 (GPIO48/SPICLK_N/SUBSPICLK_N_DIFF); also elsewhere on the board
/SDA: U12.24 (GPIO47/SPICLK_P/SUBSPICLK_P_DIFF); also elsewhere on the board
/TX: U12.10 (GPIO17/U1TXD/ADC2_CH6); also elsewhere on the board
/USB_D+: U12.14 (GPIO20/U1CTS/ADC2_CH9/CLK_OUT1/USB_D+); also elsewhere on the board
/USB_D-: U12.13 (GPIO19/U1RTS/ADC2_CH8/CLK_OUT2/USB_D-); also elsewhere on the board
/VDD: U12.38 (GPIO2/TOUCH2/ADC1_CH1); also elsewhere on the board
GND: C21.2, C30.2, C31.2, C51.2, C52.2, J5.4, J6.2, SW1.1, SW2.1, U12.1 (GND), U12.40 (GND), U12.41 (GND); also elsewhere on the board
unnamed: J6.3, U12.32 (MTCK/GPIO39/CLK_OUT3/SUBSPICS1)
unnamed: J6.4, U12.33 (MTDO/GPIO40/CLK_OUT2)
unnamed: J6.5, U12.34 (MTDI/GPIO41/CLK_OUT1)
unnamed: J6.6, U12.35 (MTMS/GPIO42)

Notes on the sheet:
Accessory Port
RTC Clock Crystal
Program the ESP32 with a ESP-PROG and a Tag Connect TC2030-IDC

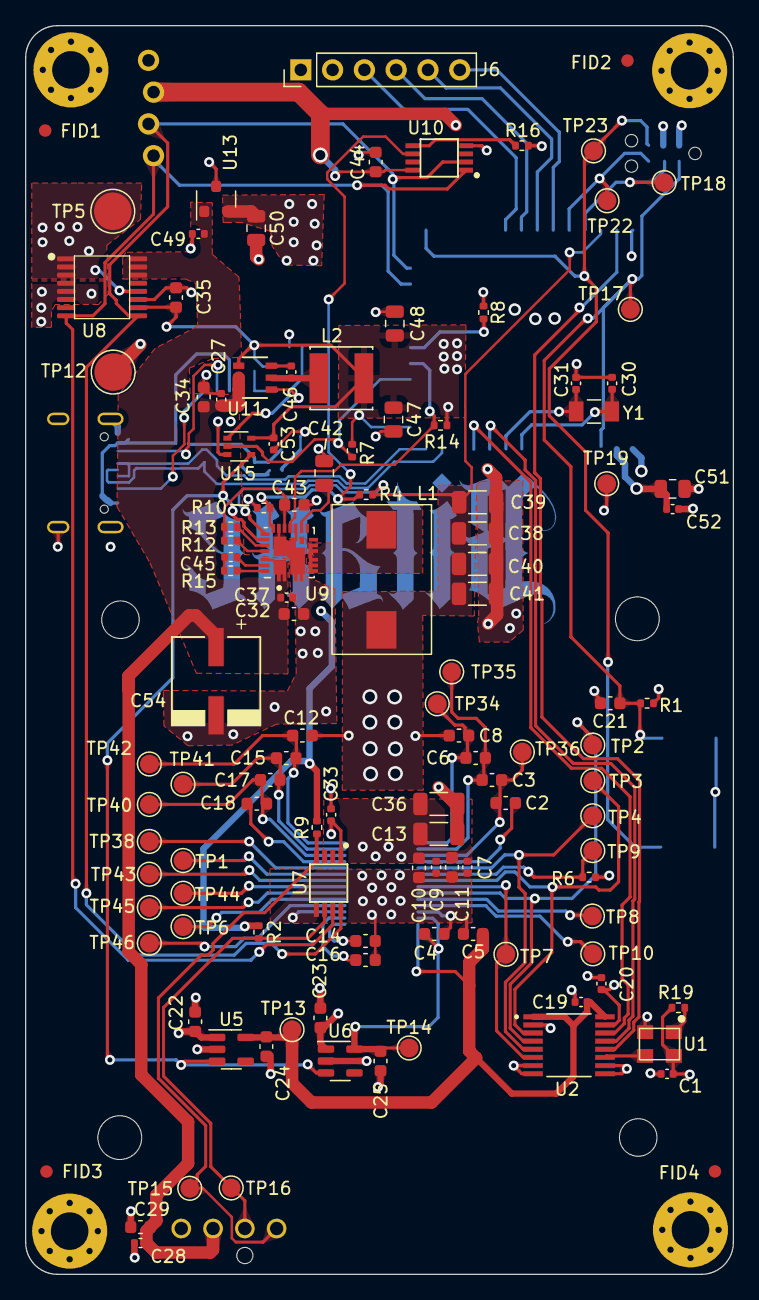
[picture p18: board bitaxeUltra.kicad_pcb from above]

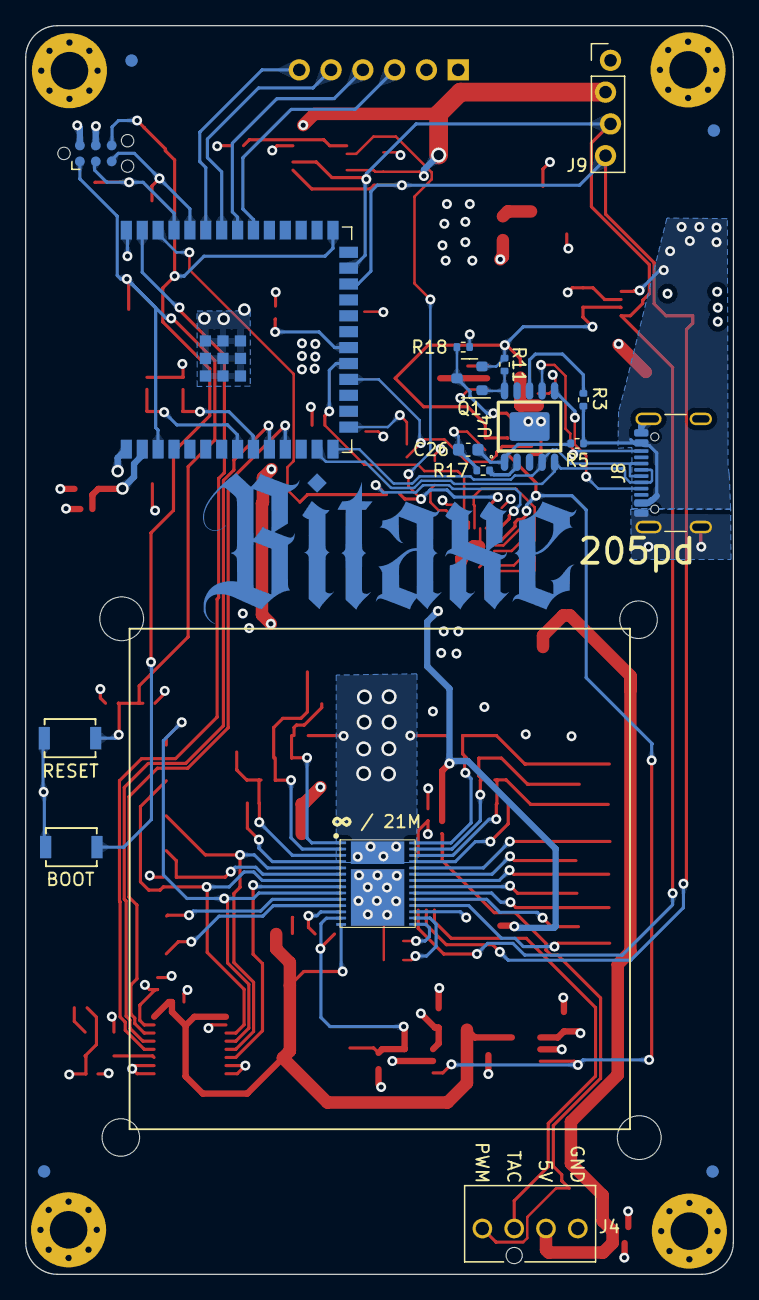
[picture p19: board bitaxeUltra.kicad_pcb from below]

Board: 4 copper layers, 56.5 x 99.8 mm, 145 parts (20 on the bottom side), 74 nets.

Other parts of the board:
R2: 5.6k; R_0402_1005Metric

Their connections:
+5V: R2.2; also elsewhere on the board
/Fan and Screen/FAN_TACH: R2.1; also elsewhere on the board
