BobAdamsEE/bitaxe/(commit log)

2024-02-14 Power analysis; updates to 205pd
    Started analysis based on the 204 with an architecture diagram and with an smath document. Copied over manually changes from the 205 branch and started updating the schematic with USB PD capabilities. Only added decoy USB PD chip (CH224K), still need to fix power supplies.
    [CUI_DEVICES_PJ-036AH-SMT-TR.step, bitaxeUltra BOM.xlsx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]
2024-02-16 Worked on VDD
    Started importing SiC431A for VDD supply. Yet to do Vfb, Mode, Pgood, boot, phase, en. Moved power supplies to power page. Configured CH224K to 12V
    [bitaxeUltra.kicad_sch, bm1366.kicad_sch, esp32.kicad_sch, fan.kicad_sch, power.kicad_sch]
2024-02-27 SCH Draft 3, PCB Start
    Finished some last minute changes to change 1V8 to 1V2 based on discord feedback. Updated level shifter and moved 25MHz oscillator to use 3V3 and be shifted down. Started working on layout.
    [SN74AVC4T774PWR.step, bitaxeUltra.kicad_pcb, bitaxeUltra.kicad_sch, bm1366.kicad_sch, esp32.kicad_sch, fan.kicad_sch, power.kicad_sch]
2024-02-27 PCB Work
    Parts now all within board but various issues still exist. Routing started, placement needs to be refined.
    [bitaxeUltra.kicad_pcb]
2024-02-29 3.3V net fix, PCB progress
    Fixed accidental use of both 3V3 and 3.3V to just use 3V3. Worked on PCB
    [bitaxeUltra.kicad_pcb, bm1366.kicad_sch, fan.kicad_sch]
2024-02-29 Layout work
    Working on power supplies - moved VDD south, added nice planes for it. Started cleaning up around new level shifter.
    [bitaxeUltra.kicad_pcb]
2024-03-04 Layout completed for concept 1
    Need to still work on vias and fills, move some parts around.
    [CAP_WCAP-ASLI_06p3X07p7_WRE.step, SIC431AED-T1-GE3.step, SPB1007.stp, TSOT26_DIO.step, VLS5045EX-100M.step, bitaxeUltra.kicad_pcb, bm1366.kicad_sch, power.kicad_sch]
2024-03-12 Release Candidate 205pd
    Everything ordered. Let's see how it goes!
    [bitaxeUltra-B_Cu.gbr, bitaxeUltra-B_Mask.gbr, bitaxeUltra-B_Paste.gbr, bitaxeUltra-B_Silkscreen.gbr, bitaxeUltra-Edge_Cuts.gbr, bitaxeUltra-F_Cu.gbr, bitaxeUltra-F_Mask.gbr, bitaxeUltra-F_Paste.gbr]
2024-03-21 KiCad 8 + InteractiveHTMLBOM
    Updated to KiCad 8 and some auto-conversions occurred. Generated interactive HTML BOM to prepare for assembly.
    [bitaxeUltra.kicad_pcb, bitaxeUltra.kicad_sch, bm1366.kicad_sch, esp32.kicad_sch, fan.kicad_sch, power.kicad_sch]
